TeHSiGGi/espbalcony/README.md

# espbalcony

## ARDUINO NANO BUILD CONFIG ##
Board: Arduino Nano
Processor: Atmega 328
Baud: 9600

## ESP-12 BUILD CONFIG ##
Board: Generic ESP8266 Module
Flash Mode: DIO
Flash Frequency: 40MHz
CPU Frequency: 80MHz
Flash Size: 4M (1M)
Debug Port: disabled
Debug Level: none
Reset Method: ck
Upload Speed: 115200
Baud: 115200
