TeHSiGGi/espbalcony/documentation/hardware/pin_overview.png

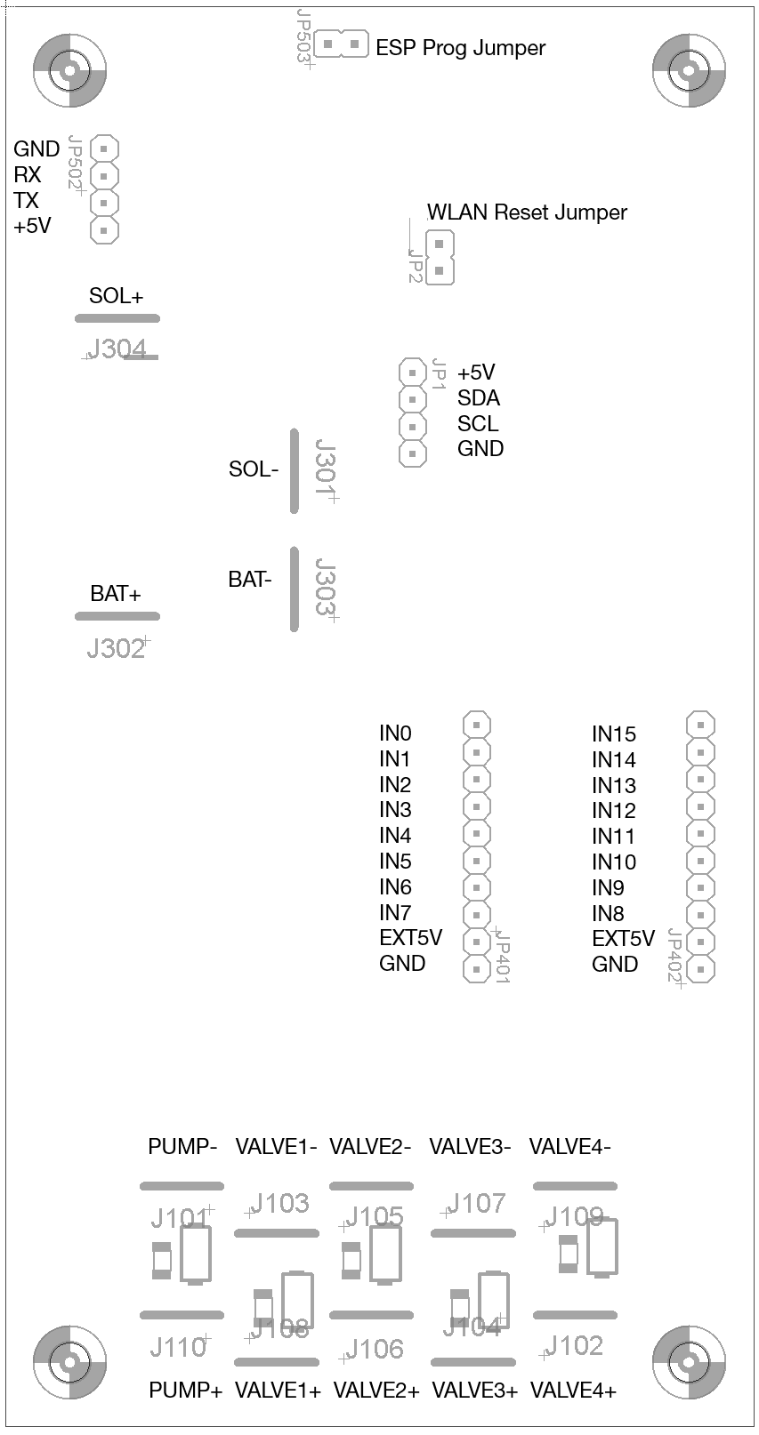
documentation/hardware/pin_overview.png
