TeHSiGGi/espbalcony/hardware/eagle/cpu.brd

## EAGLE design hardware/eagle/cpu.brd (2017-11-04)

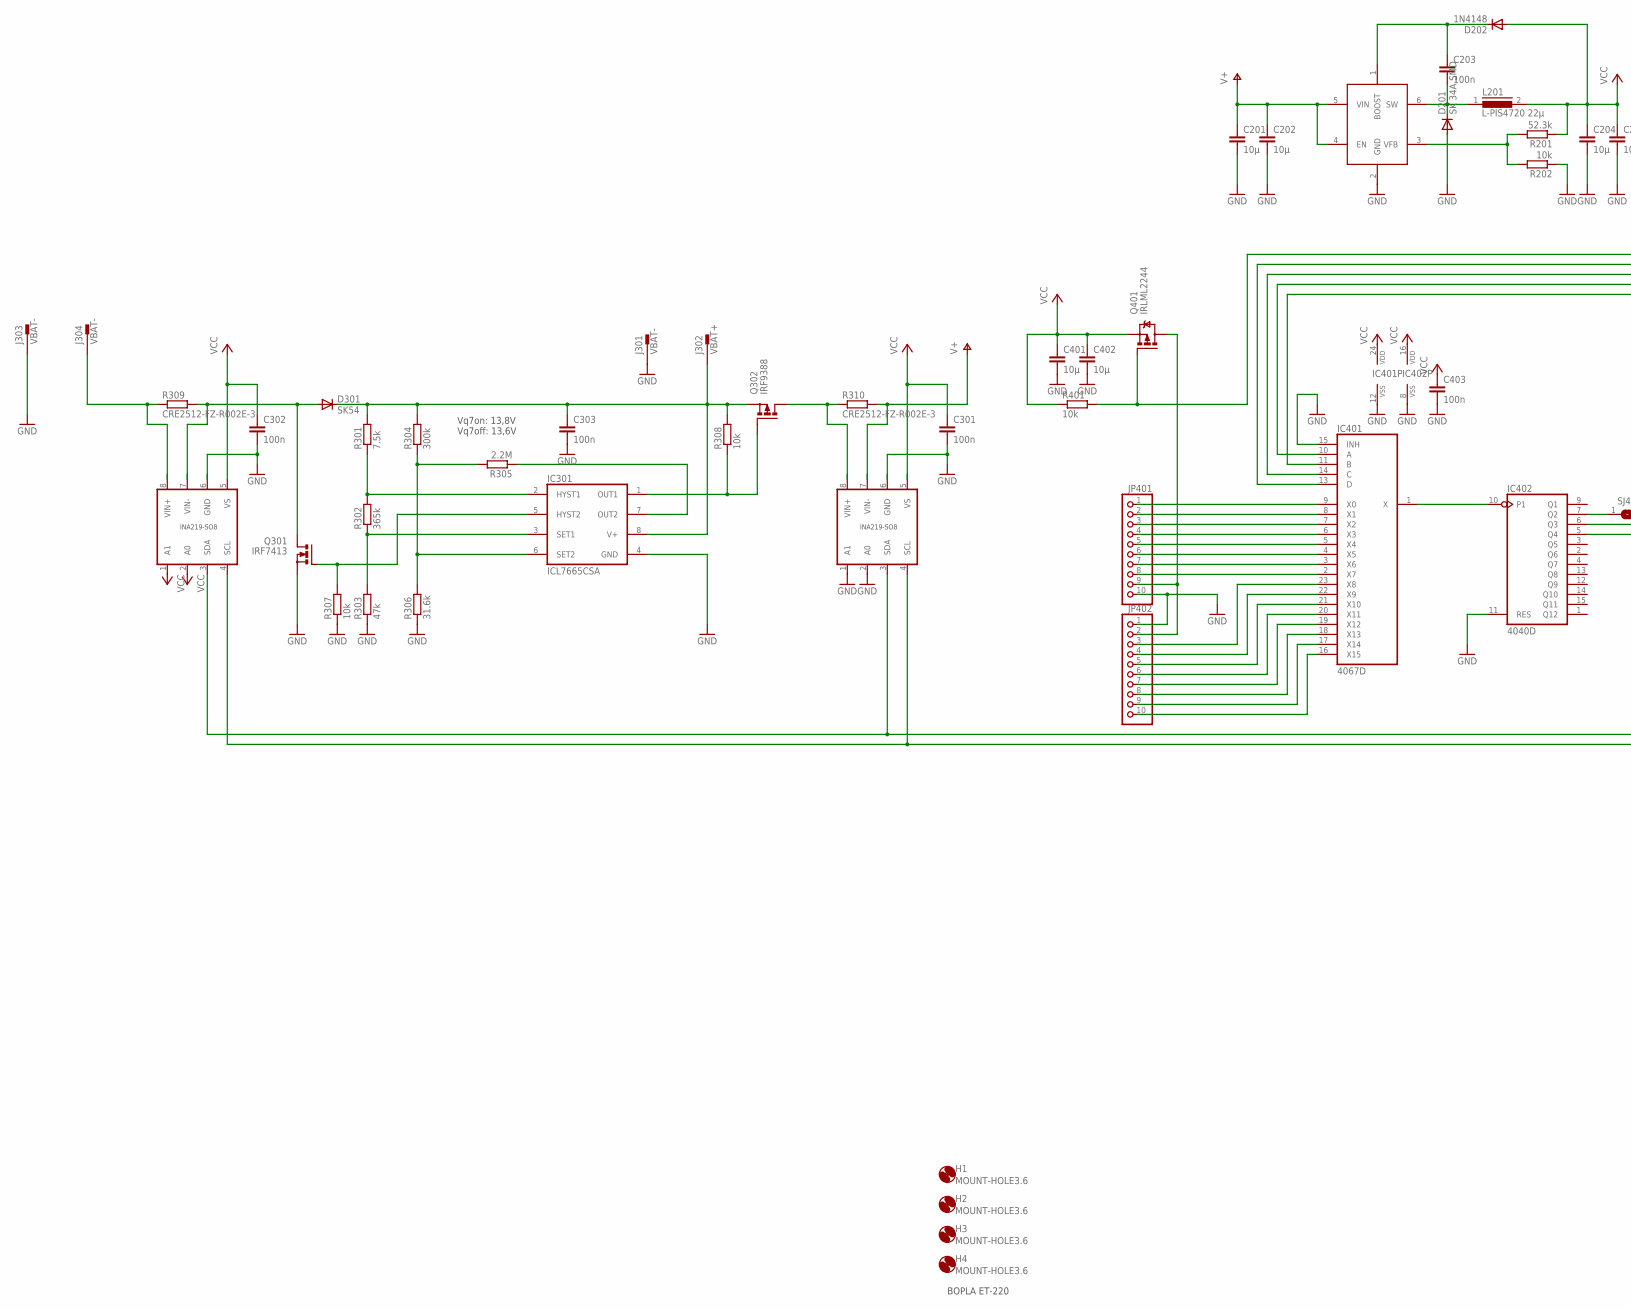
[picture p2: schematic cpu.sch, part in row 1, column 1]

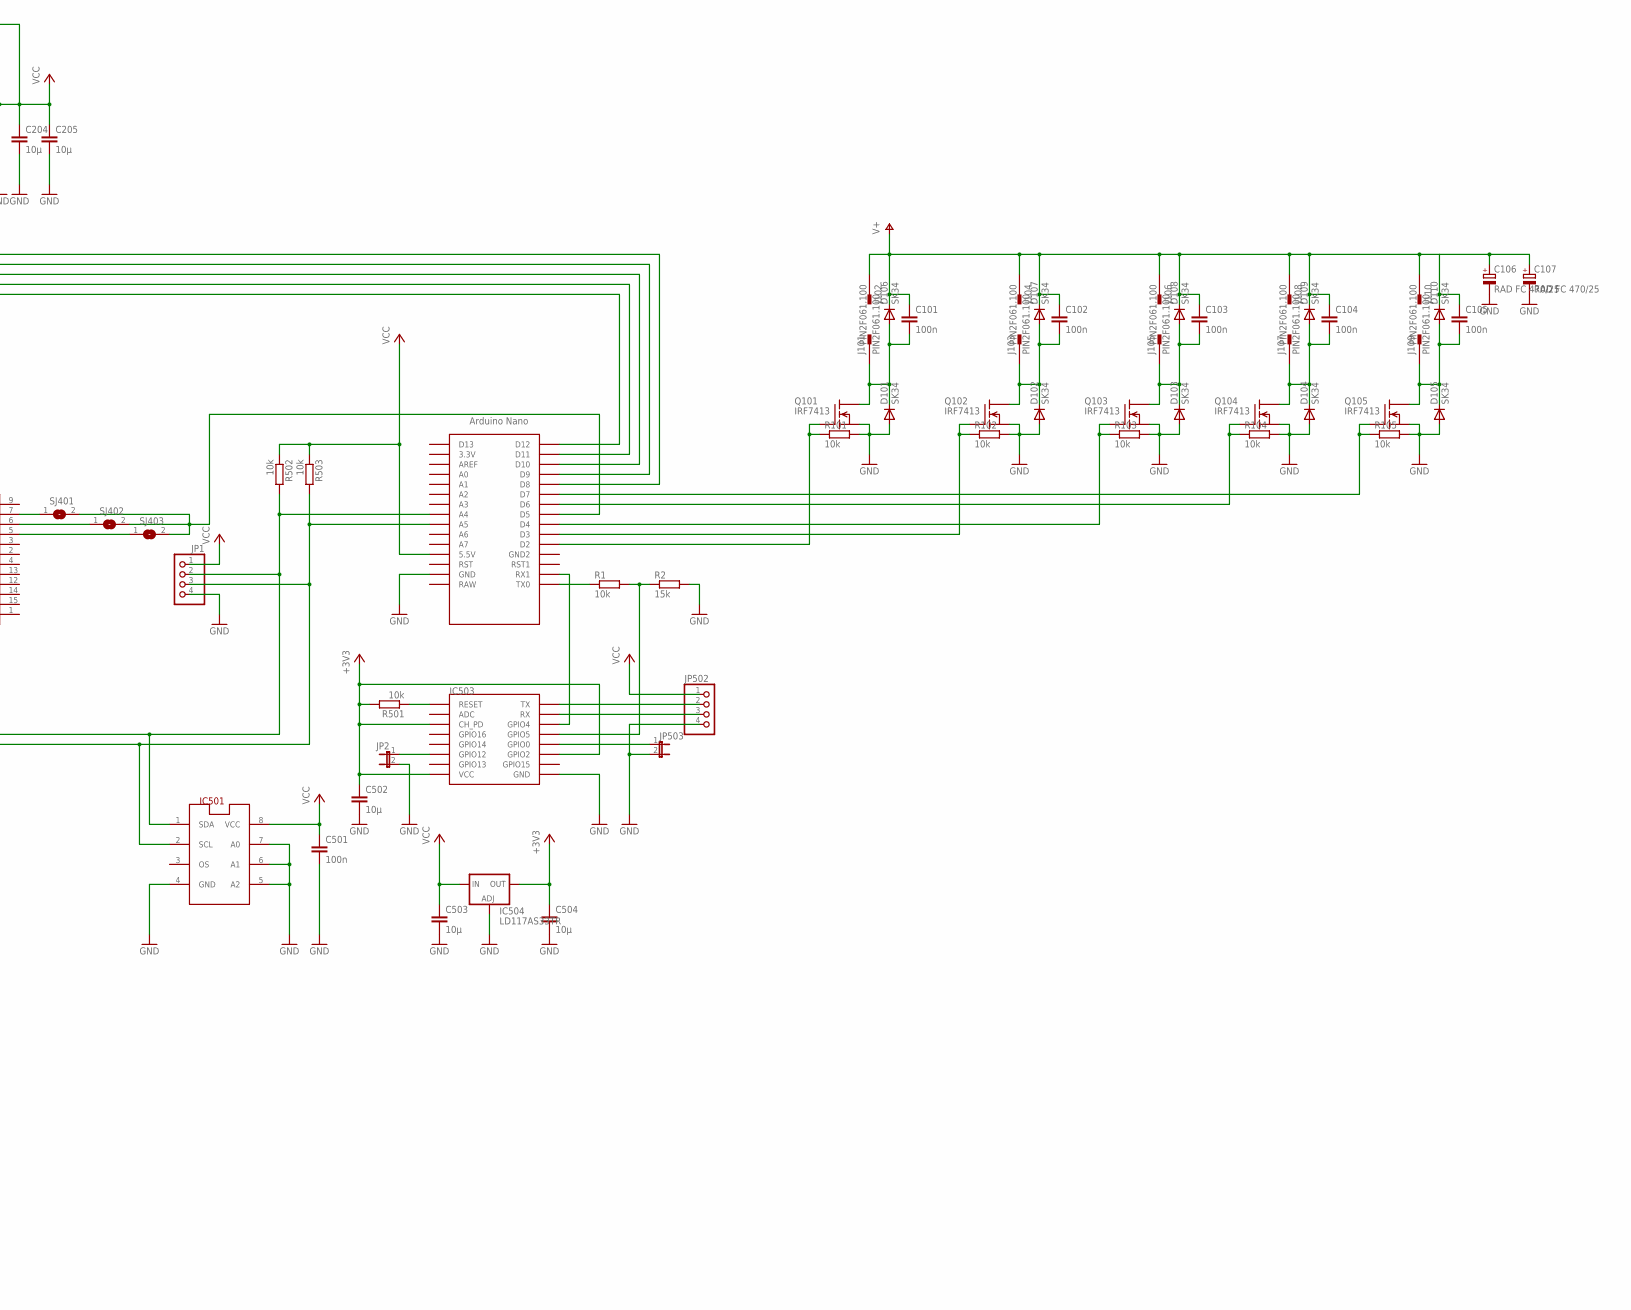
[picture p3: schematic cpu.sch, part in row 1, column 2]

Parts:
C101, C102, C103, C104, C105, C203, C301, C302, C303, C403, C501: 100n; C1206
C106, C107: RAD FC 470/25; E3,5-8
C201, C202, C204, C205, C401, C402, C502, C503, C504: 10µ; C1206
D101, D102, D103, D104, D105, D106, D107, D108, D109, D110: SK34; DO214BA
D201: SK 34A SMD; DO214BA
D202: 1N4148; MINIMELF
D301: SK54; SMC
H1, H2, H3, H4: MOUNT-HOLE3.6; 3,6
IC201: MCP16301/H; SOT23-6
IC301: ICL7665CSA; SO08
IC302, IC303: INA219-SO8D; SO08
IC401: 4067D; SO24W
IC402: 4040D; SO16
IC501: LM75_ICN; SO8_LM75
IC502: NANO
IC503: ESP12SMD; ESP12-SMD
IC504: LD117AS33TR; SOT223
J101, J102, J103, J104, J105, J106, J107, J108, J109, J110: PIN2F061.100; F061.100
J301, J303, J304: VBAT-; F061.100
J302: VBAT+; F061.100
JP1, JP502: PINHD-1X4; 1X04
JP2, JP503: JP1E; JP1
JP401, JP402: PINHD-1X10; 1X10
L201: L-PIS4720 22µ; DR74
Q101, Q102, Q103, Q104, Q105: IRF7413; SO-8
Q301: IRF7413; SO-08
Q302: IRF9388; SO-08
Q401: IRLML2244; MICRO3
R1, R101, R102, R103, R104, R105, R202, R307, R308, R401, R501, R502, R503: 10k; R0805
R2: 15k; R0805
R201: 52.3k; R0805
R301: 7.5k; R0805
R302: 365k; R0805
R303: 47k; R0805
R304: 300k; R0805
R305: 2.2M; R0805
R306: 31.6k; R0805
R309, R310: CRE2512-FZ-R002E-3; R2512
SJ401, SJ402, SJ403: SJW

Connections:
+3V3: C502.1, C504.1, IC503.CH_PD, IC503.GPIO2, IC503.VCC, IC504.4 (OUT), R501.2
G-N: IC301.5 (HYST2), Q301.4 (G), R307.2
GND: C106.-, C107.-, C201.2, C202.2, C204.2, C205.2, C301.2, C302.2, C303.2, C401.2, C402.2, C403.2, C501.2, C502.2, C503.2, C504.2, D101.A, D102.A, D103.A, D104.A, D105.A, D201.A, IC201.2 (GND), IC301.4 (GND), IC302.6 (GND), IC303.1 (A1), IC303.2 (A0), IC303.6 (GND), IC401.12 (VSS), IC401.15 (INH), IC402.8 (VSS), IC402.11 (RES), IC501.4 (GND), IC501.5 (A2), IC501.6 (A1), IC501.7 (A0), IC502.GND, IC503.GND, IC504.1 (ADJ), J301.A1, J301.A2, J303.A1, J303.A2, JP1.4, JP2.2, JP401.10, JP402.1, JP502.4, JP503.2, Q101.1 (S), Q101.2 (S), Q101.3 (S), Q102.1 (S), Q102.2 (S), Q102.3 (S), Q103.1 (S), Q103.2 (S), Q103.3 (S), Q104.1 (S), Q104.2 (S), Q104.3 (S), Q105.1 (S), Q105.2 (S), Q105.3 (S), Q301.1 (S), Q301.2 (S), Q301.3 (S), R2.2, R101.2, R102.2, R103.2, R104.2, R105.2, R202.1, R303.1, R306.1, R307.1
unnamed: IC502.D6, Q104.4 (G), R104.1
unnamed: IC502.D4, Q103.4 (G), R103.1
unnamed: IC502.D3, Q102.4 (G), R102.1
unnamed: IC502.D2, Q101.4 (G), R101.1
unnamed: IC502.D7, Q105.4 (G), R105.1
unnamed: IC401.9 (X0), JP401.1
unnamed: IC401.8 (X1), JP401.2
unnamed: IC401.7 (X2), JP401.3
unnamed: IC401.6 (X3), JP401.4
unnamed: IC401.5 (X4), JP401.5
unnamed: IC401.4 (X5), JP401.6
unnamed: IC401.3 (X6), JP401.7
unnamed: IC401.2 (X7), JP401.8
unnamed: IC401.23 (X8), JP402.3
unnamed: IC401.22 (X9), JP402.4
unnamed: IC401.21 (X10), JP402.5
unnamed: IC401.20 (X11), JP402.6
unnamed: IC401.19 (X12), JP402.7
unnamed: IC401.18 (X13), JP402.8
unnamed: IC401.17 (X14), JP402.9
unnamed: IC401.16 (X15), JP402.10
unnamed: IC401.1 (X), IC402.10 (P1)
unnamed: IC401.11 (B), IC502.D12
unnamed: IC402.7 (Q2), SJ401.1
unnamed: IC402.6 (Q3), SJ402.1
unnamed: IC402.5 (Q4), SJ403.1
unnamed: IC502.D5, SJ401.2, SJ402.2, SJ403.2
unnamed: JP401.9, JP402.2, Q401.3 (D)
unnamed: IC502.RX1, IC503.GPIO4
unnamed: IC502.D8, Q401.1 (G), R401.2
unnamed: C203.1, D202.C, IC201.1 (BOOST)
unnamed: IC503.GPIO5, R1.2, R2.1
unnamed: IC201.3 (VFB), R201.2, R202.2
unnamed: IC401.10 (A), IC502.D11
unnamed: IC503.RESET, R501.1
unnamed: IC401.14 (C), IC502.D10
unnamed: IC401.13 (D), IC502.D9
unnamed: IC503.GPIO0, JP503.1
unnamed: IC503.TXD0 (TX), JP502.2
unnamed: IC503.RXD0 (RX), JP502.3
unnamed: IC303.8 (VIN+), Q302.5 (D), Q302.6 (D), Q302.7 (D), Q302.8 (D), R310.1
unnamed: IC502.TX0, R1.1
unnamed: IC301.6 (SET2), R304.1, R305.2, R306.2
unnamed: IC301.3 (SET1), R302.1, R303.2
unnamed: IC301.2 (HYST1), R301.1, R302.2
unnamed: IC301.7 (OUT2), R305.1
unnamed: IC301.1 (OUT1), Q302.4 (G), R308.1
unnamed: IC503.GPIO12, JP2.1
PUMP: C101.2, D101.C, D106.A, J101.A1, J101.A2, Q101.5 (D), Q101.6 (D), Q101.7 (D), Q101.8 (D)
SCL: IC302.4 (SCL), IC303.4 (SCL), IC501.2 (SCL), IC502.A5, JP1.3, R503.2
SDA: IC302.3 (SDA), IC303.3 (SDA), IC501.1 (SDA), IC502.A4, JP1.2, R502.2
SW: C203.2, D201.C, IC201.6 (SW), L201.1
V+: C101.1, C102.1, C103.1, C104.1, C105.1, C106.+, C107.+, C201.1, C202.1, D106.C, D107.C, D108.C, D109.C, D110.C, IC201.4 (EN), IC201.5 (VIN), IC303.7 (VIN-), J102.A1, J102.A2, J104.A1, J104.A2, J106.A1, J106.A2, J108.A1, J108.A2, J110.A1, J110.A2, R310.2
VBAT: C303.1, D301.C, IC301.8 (V+), J302.A1, J302.A2, Q302.1 (S), Q302.2 (S), Q302.3 (S), R301.2, R304.2, R308.2
VCC: C204.1, C205.1, C301.1, C302.1, C401.1, C402.1, C403.1, C501.1, C503.1, D202.A, IC302.1 (A1), IC302.2 (A0), IC302.5 (VS), IC303.5 (VS), IC401.24 (VDD), IC402.16 (VDD), IC501.8 (VCC), IC502.5V (5.5V), IC504.3 (IN), JP1.1, JP502.1, L201.2, Q401.2 (S), R201.1, R401.1, R502.1, R503.1
VENT1: C102.2, D102.C, D107.A, J103.A1, J103.A2, Q102.5 (D), Q102.6 (D), Q102.7 (D), Q102.8 (D)
VENT2: C103.2, D103.C, D108.A, J105.A1, J105.A2, Q103.5 (D), Q103.6 (D), Q103.7 (D), Q103.8 (D)
VENT3: C104.2, D104.C, D109.A, J107.A1, J107.A2, Q104.5 (D), Q104.6 (D), Q104.7 (D), Q104.8 (D)
VENT4: C105.2, D105.C, D110.A, J109.A1, J109.A2, Q105.5 (D), Q105.6 (D), Q105.7 (D), Q105.8 (D)
VSOL: D301.A, IC302.7 (VIN-), Q301.5 (D), Q301.6 (D), Q301.7 (D), Q301.8 (D), R309.2
VSOLRAW: IC302.8 (VIN+), J304.A1, J304.A2, R309.1

Notes on the sheet:
BOPLA ET-220
Vq7on: 13,8V Vq7off: 13,6V

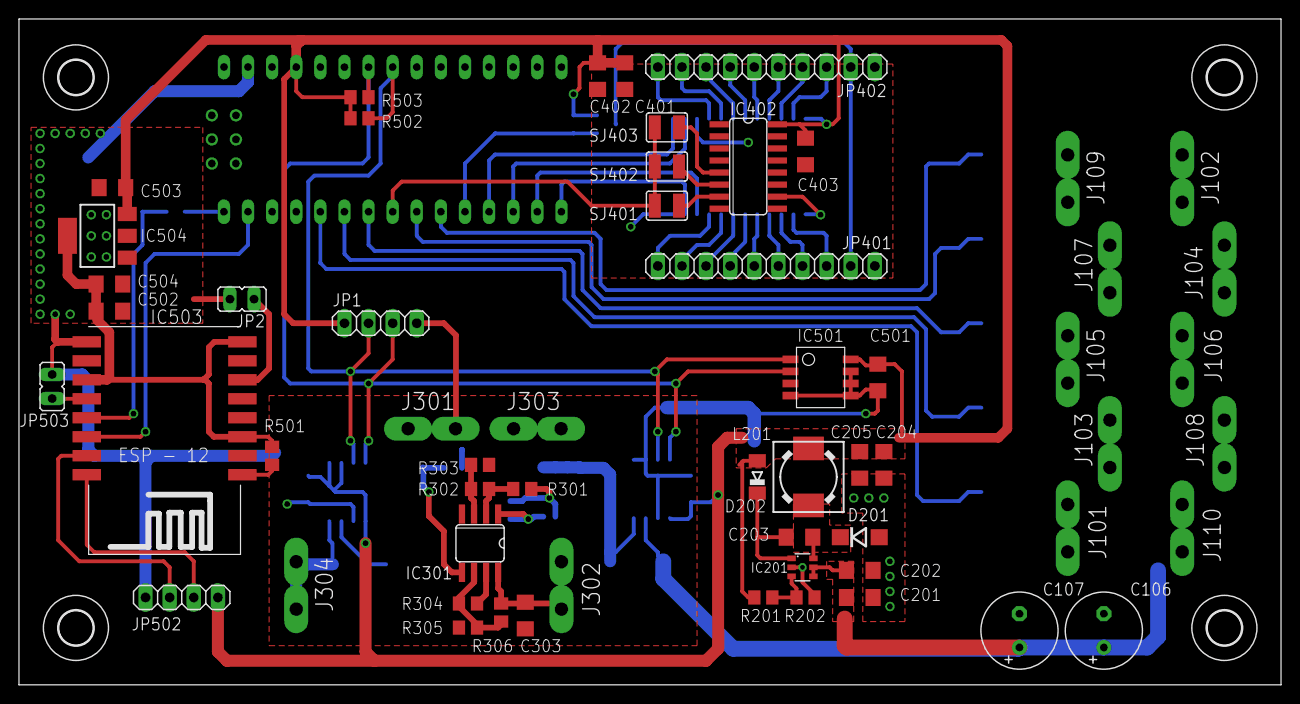
[picture p4: board cpu.brd from above]

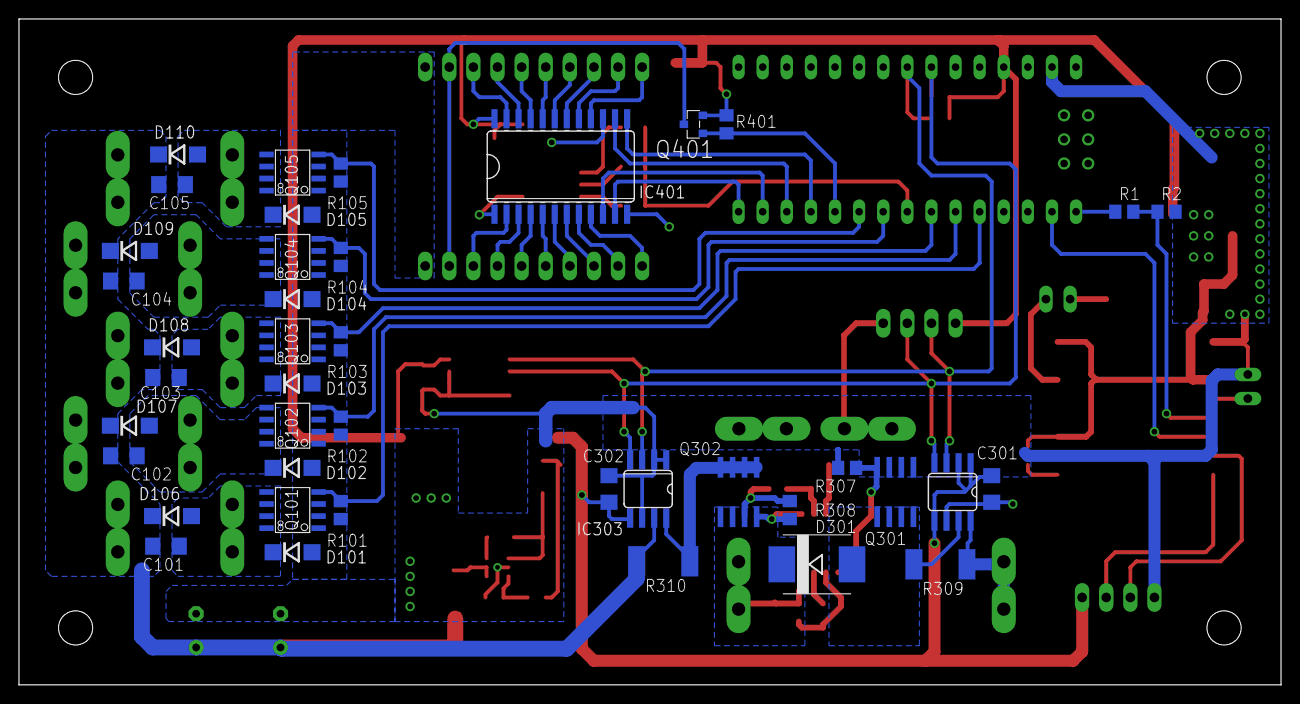
[picture p5: board cpu.brd from below]

Board: 2 copper layers, 133.0 x 70.2 mm, 104 parts (41 on the bottom side), 64 nets.
