TeHSiGGi/espbalcony/(threads)

Thread 10 (2017-11-04):

Provide Arduino Port mapping and I²C Addresses

TeHSiGGi, 2017-11-04:
Provide an overview of I²C Addresses and port mappings of Arduino NANO.

TeHSiGGi, 2017-11-04:
fixed with #11

Closed 2017-11-04.

Thread 7 (2017-11-04):

Function to control magnetic valve

TeHSiGGi, 2017-11-04:
Function needs to control one of the four mangetic valves by a given state:

true: Pump N is on (GPIO X is HIGH);
false: Pump N is off (GPIO X is LOW);

Pump 1: GPIO D3
Pump 2: GPIO D4
Pump 3: GPIO D6
Pump 4: GPIO D7
