TeHSiGGi/espbalcony/(commit log)

2017-11-04 Pushed Eagle files with Gerber export and BOM
    [cpu.brd, cpu.csv, cpu.sch, cpu_bom.csv, cpu_bom.xlsx]
2017-11-04 Added arduino IDE based software for ESP and NANO
2017-11-05 Restructured Arduino Directories
